ProyectoFinal2018/HW_Dron_V2/HW_Dron_V2.xls

Comment | Description | Proveedor | Cod. Proveedor | Encapsulado | Link | Quantity
IDC10 Macho Recto P=2.54mm | Header, 5x2-pin pinout horizontal | SDV Electronica |  | Through Hole | http://www.sdvelectronica.com.ar/conector-macho-recto-cable-plano-idc-10-pines-10-uni-139259442xJM | 10
IDC16 Macho Recto P=2.54mm | Modulo camara OV7670 | SDV Electronica |  |  | http://www.sdvelectronica.com.ar/conector-macho-recto-cable-plano-idc-16-pines-10-uni-146797591xJM | 10
2,2uF 16V X7R | Capacitor de placas paralelas | Mouser | 80-C0805C225K4R3123 | C0805 | https://ar.mouser.com/ | 50
ATWINC15x0-MR210 | IEEE 802.11 b/g/n SmartConnect IoT Module | Mouser | 556-1500MR210PB1952 | ATWINC15x0-MR210PB | https://ar.mouser.com/ | 5
BQ7692006PWR | 3-Series to 5-Series Cell Battery Monitor | Mouser | 595-BQ7692006PWR | TSSOP-20 | https://ar.mouser.com/ | 10
MPU9250 | IMU 9DOF | Mouser | 410-MPU-9250 | QFN24 | https://ar.mouser.com/ | 10
PSJ2NTEBL500F | Resistencia shunt 0.5mohm 10W | Mouser | 660-PSJ2NTEBL500F | SMD | https://ar.mouser.com | 10
STM32F407VGT6-100 | Microcontrolador STM32F407VGT6 100 pines | Mouser | 511-STM32F407VGT6 | QFP100 | https://ar.mouser.com/ | 10
XBEE PRO S2C MODULE | Conector modulo Zigbee Series 2 C | Mouser | 888-XBP24CAUIT-001 | Through Hole | https://ar.mouser.com/ | 2
XBeePRO_S2C-SMT | Conector modulo Zigbee Series 2 C encapsulado SMT | Mouser | 888-XB24CDMPIS-001 | SMT | https://ar.mouser.com/ | 5
100nF 50V X7R | Capacitor de placas paralelas | Microelectronica | C0805-0.1 | C0805 | http://www.microelectronicash.com/ | 200
10nF 25V X7R | Capacitor de placas paralelas | Microelectronica | C0805-0.01 | C0805 | http://www.microelectronicash.com/ | 100
1uF 16V X7R | Capacitor de placas paralelas | Microelectronica | C0805-1UF | C0805 | http://www.microelectronicash.com/ | 100
HEMB.P/CAB.PLANO 2X20 P=2.54mm | Conector para odroid c1+ | Elemon | CO4751060 | Through Hole | http://www.elemon.net | 10
0E 5% 1/8W | Resistencia | Elemon | RS3895900 | R0805 | http://www.elemon.net/ | 100
100E 5% 1/8W | Resistencia | Elemon | RS3896125 | R0805 | http://www.elemon.net/ | 100
100k 5% 1/8W | Resistencia | Elemon | RS3896305 | R0805 | http://www.elemon.net/ | 100
10k 5% 1/8W | Resistencia | Elemon | RS3896245 | R0805 | http://www.elemon.net/ | 100
10pF 50V | Capacitor de placas paralelas | Elemon | CA3278360 | C0805 | http://www.elemon.net/ | 100
10uF 25V 10% Tantalio | Capacitor polarizado | Elemon | CA3389022K | AVX C Case | http://www.elemon.net/ | 30
1k 5% 1/8W | Resistencia | Elemon | RS3896185 | R0805 | http://www.elemon.net/ | 100
1M 5% 1/8W | Resistencia | Elemon | RS3896365 | R0805 | http://www.elemon.net/ | 100
1N4007 | Diodo | Elemon | DI1202221 | SMA | http://www.elemon.net/ | 100
220uF 35V Electrolitico | Capacitor polarizado | Elemon | CA3629381 | CS8x10,5 SMD | http://www.elemon.net/ | 20
22E 5% 1/8W | Resistencia | Elemon | RS3896085 | R0805 | http://www.elemon.net/ | 100
270E 5% 1/8W | Resistencia | Elemon | RS3896150 | R0805 | http://www.elemon.net/ | 100
2k2 5% 1/8W | Resistencia | Elemon | RS3896205 | R0805 | http://www.elemon.net/ | 100
2k7 5% 1/8W | Resistencia | Elemon | RS3896210 | R0805 | http://www.elemon.net/ | 100
32.768KHZ C26T CQ | Resonador cerámico | Elemon | OS9009152 | Through Hole | http://www.elemon.net | 10
390E 5% 1/8W | Resistencia | Elemon | RS3896160 | R0805 | http://www.elemon.net/ | 100
3k9 5% 1/8W | Resistencia | Elemon | RS3896220 | R0805 | http://www.elemon.net/ | 100
470E 5% 1/8W | Resistencia | Elemon | RS3896165 | R0805 | http://www.elemon.net/ | 100
470uF 16V Electrolitico | Capacitor polarizado | Elemon | CA3629085 | 10x10 SMD | http://www.elemon.net/ | 20
47E 5% 1/8W | Resistencia | Elemon | RS3896105 | R0805 | http://www.elemon.net/ | 100
8MHz HC-49U/S CQ | Resonador cerámico | Elemon | OS9009452 | Through Hole | http://www.elemon.net | 10
DC Power Jack 2.5 RA | DC Power Jack 2.5 Right Angle Type Thin Plated Black Insulator ROHS | Elemon | MC6691355 | JACK_2.5DC_RA | http://www.elemon.net/ | 10
LM1117DTX-3.3/NOPB | Low dropout oscilator | Elemon | CI2707214D | TO-252-3 | http://www.elemon.net/ | 10
LM2596S-ADJ/NOPB | Switching Step-Down Voltage Regulator | Elemon | CI2709940 | TSS5B | http://www.elemon.net/ | 20
MA-02 VERT.P=2.54MM WF2S | Header, 2-pin | Elemon | CO5073010 | Through Hole | http://www.elemon.net | 40
MA-04 HORIZ.P=2.54MM WF4R | Conector para modulo ultrasonido de 40kHz | Elemon | CO5073040 | Through Hole | http://www.elemon.net | 50
STPS5L60S | Diodo Schottky | Elemon | DI1351350 | SMC | http://www.elemon.net/ | 60
TAC-SWITCH 4 CONT.6X6MM (7MM) 180GF | Pulsador de 4 pines | Elemon | MC5702109 | Through Hole | http://www.elemon.net | 10
ASP-129637-13 | PCIe/104 Connector A, OneBank Bottom | Digikey | SAM10885-ND | Surface Mount | https://www.digikey.com/ | 2
ASP-129646-22 | PCIe/104 Connector A, OneBank Bottom | Digikey | SAM10886-ND | Surface Mount | https://www.digikey.com/ | 2
BMP280 | Sensor de presion digital | Digikey | 828-1064-1-ND | 8-SMD | https://www.digikey.com/ | 10
CAP 220MF -20% +80% 3.3V SMD | Capacitor polarizado | Digikey | 604-1020-1-ND | SMD | https://www.digikey.com | 10
CONN HEADER PH TOP 3POS 2MM | Header, 3-pin | Digikey | 455-1705-ND | Through Hole | https://www.digikey.com | 40
CONN HEADER XH SIDE 2POS 2.5MM | Header, 2-pin | Digikey | 455-2257-ND | Through Hole | https://www.digikey.com | 40
CONN HEADER XH SIDE 4POS 2.5MM | Header, 4-pin | Digikey | 455-2243-ND | Through Hole | https://www.digikey.com/ | 40
DR127-330-R | Inductor | Digikey | M8852-ND | Through Hole | https://www.digikey.com/ | 20
CONN HOUSING PH 3POS 2.0MM | Conector hembra JST-PH 3 | Digikey | 455-1126-ND |  | https://www.digikey.com/ | 40
CONN TERMINAL 28-24AWG TIN | Conector terminal para JST | Digikey | 455-2148-1-ND |  | https://www.digikey.com/ | 40
4.7uF 16V | Capacitor de placas paralelas | Elemon | CA3279960 | C0805 | http://www.elemon.net/ | 50
2x5 Pin IDC Ribbon Cable | Cable con conectores hembra IDC10 | Sparkfun |  |  | https://www.sparkfun.com/products/8535 | 10
POSTE 90gra 40C SIMPLE FILA BAJO P=2.54MM | Poste simple fila 90 grados de 40 pines P=2.54mm | Elemon | CO4901060 |  | http://www.elemon.net/ | 10
POSTE RECTO 40C SF P=2.54MM | Poste simple fila recto de 40 pines P=2.54mm | Elemon | CO4901010 |  | http://www.elemon.net/ | 10
POSTE RECTO 80C DF P=2.54MM | Poste doble fila recto de 80 pines P=2.54mm | Elemon | CO4901030 |  | http://www.elemon.net/ | 10
CONN HOUSING 2.5MM 4POS | Housing JST-XH 4posiciones | Digikey | 455-2267-ND |  | https://www.digikey.com/ | 40
CABLE PLANO 50CONDUCT | Cable plano con 50 conductores P=0.05'' | Elemon | MC5351075 |  | http://www.elemon.net/ | 40
PIN HEMBRA PARA HOUSING TIPO HUX HU | Terminal para conector hembra para housing para HUX HU | Elemon | CO5073600 |  | http://www.elemon.net/ | 40
HE-04 P/CABLE P=2.54MM HU4 | Conector hembra housing HU4 | Elemon | CO5073230 |  | http://www.elemon.net/ | 40
OV7670 | Camara | Ebay |  |  | https://www.ebay.com/itm/VGA-OV7670-CMOS-Camera-Module-Lens-CMOS-640X480-SCCB-Compatible-W-I2C-Interface-/400373092344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 | 2
STLINK V2 MINI CON IDC10 | Debugger STLINK V2 MINI con conector IDC10 (2x5) | Monarca Electronica |  |  | https://www.monarcaelectronica.com.ar/programadores/programador-dbuger-usb-st-link-v2-stm32-stm8-con-cable-mona/ | 10
SEPARADOR 20MM PASANTE 1/8" | Separador de 1/8'' 20mm | Elemon | MC6451075 |  | http://www.elemon.net/ | 100
Bateria Li-Po 11.1V 3S 2200mAh | Bateria Li-Po de 11.1V y 2200mAh | Hobbyfiesta |  |  | https://articulo.mercadolibre.com.ar/MLA-704200986-bateria-lipo-3s-111v-2200mah-drones-avion-rc-turnigy-litio-_JM | 5
Ficha Xt-60 macho | Fichas xt-60 macho | RC FLASH |  |  | https://articulo.mercadolibre.com.ar/MLA-692913500-5-pares-fichas-xt-60-drones-autos-aviones-a-rc-litio-lipo-_JM | 10
Ficha Xt-60 hembra | Fichas xt-60 hembra | RC FLASH |  |  | https://articulo.mercadolibre.com.ar/MLA-692913500-5-pares-fichas-xt-60-drones-autos-aviones-a-rc-litio-lipo-_JM | 10
Conector Dean T macho | Fichas Dean T macho | Hobbyfiesta |  |  | https://articulo.mercadolibre.com.ar/MLA-674440105-ficha-conector-dean-t-el-par-macho-hembra-radio-control-_JM | 10
Conector Dean T hembra | Fichas Dean T hembra | Hobbyfiesta |  |  | https://articulo.mercadolibre.com.ar/MLA-674440105-ficha-conector-dean-t-el-par-macho-hembra-radio-control-_JM | 10
ESC+Brushless+Helices x4 | Combo Motor Brushless + Speed Esc 30a + Helices Drone Avion x4 todo | Hobbyfiesta |  |  | https://articulo.mercadolibre.com.ar/MLA-690426244-oferta-combo-4-motores-brushless-4-speed-esc-30-amp-8-helice-_JM | 5
MEMORIA KINGSTON 32GB MICRO SD HC CLASS 10 | Memoria Micro SD 32GB clase 10 KINGSTON | PASCAL ONLINE |  |  | https://pascalonline.com.ar/producto/memoria-32gb-micro-sd-hc-class-10/ | 15
Frame F450 |  | ebay |  |  | https://www.ebay.com/itm/F450-Multicopter-Frame-Arm-For-DJI-Center-Plate-TOP-And-Bottom-Landing-Wheel/263110310141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 | 5
ODROID C1+ |  | Hardkernel |  |  | http://www.hardkernel.com/main/products/prdt_info.php?g_code=G143703355573 | 3
Rc Futaba + Receptor | Radiocontrol Futaba + receptor |  |  |  | https://articulo.mercadolibre.com.ar/MLA-607281142-rc-futaba-6-canales-receptor-uav-drones-fpv-_JM | 1
SiK telemetry radio | HKPilot Transceiver Telemetry Radio Set V2 | Hobbyking |  |  | https://hobbyking.com/en_us/hkpilot-transceiver-telemetry-radio-set-v2-433mhz.html | 5
Autopilot DJI Naza M-Lite | Kit del DJI Naza |  |  |  | https://articulo.mercadolibre.com.ar/MLA-722191450-autopilot-dji-naza-m-lite-drone-v11-con-antena-gps-ubec-_JM | 5
Scanse Sweep | Lidar 360 grados | Sparkfun |  |  | https://www.sparkfun.com/products/retired/14117 | 1
