ProyectoFinal2018/HW_Dron_V2/HW_Dron_V2.PDF

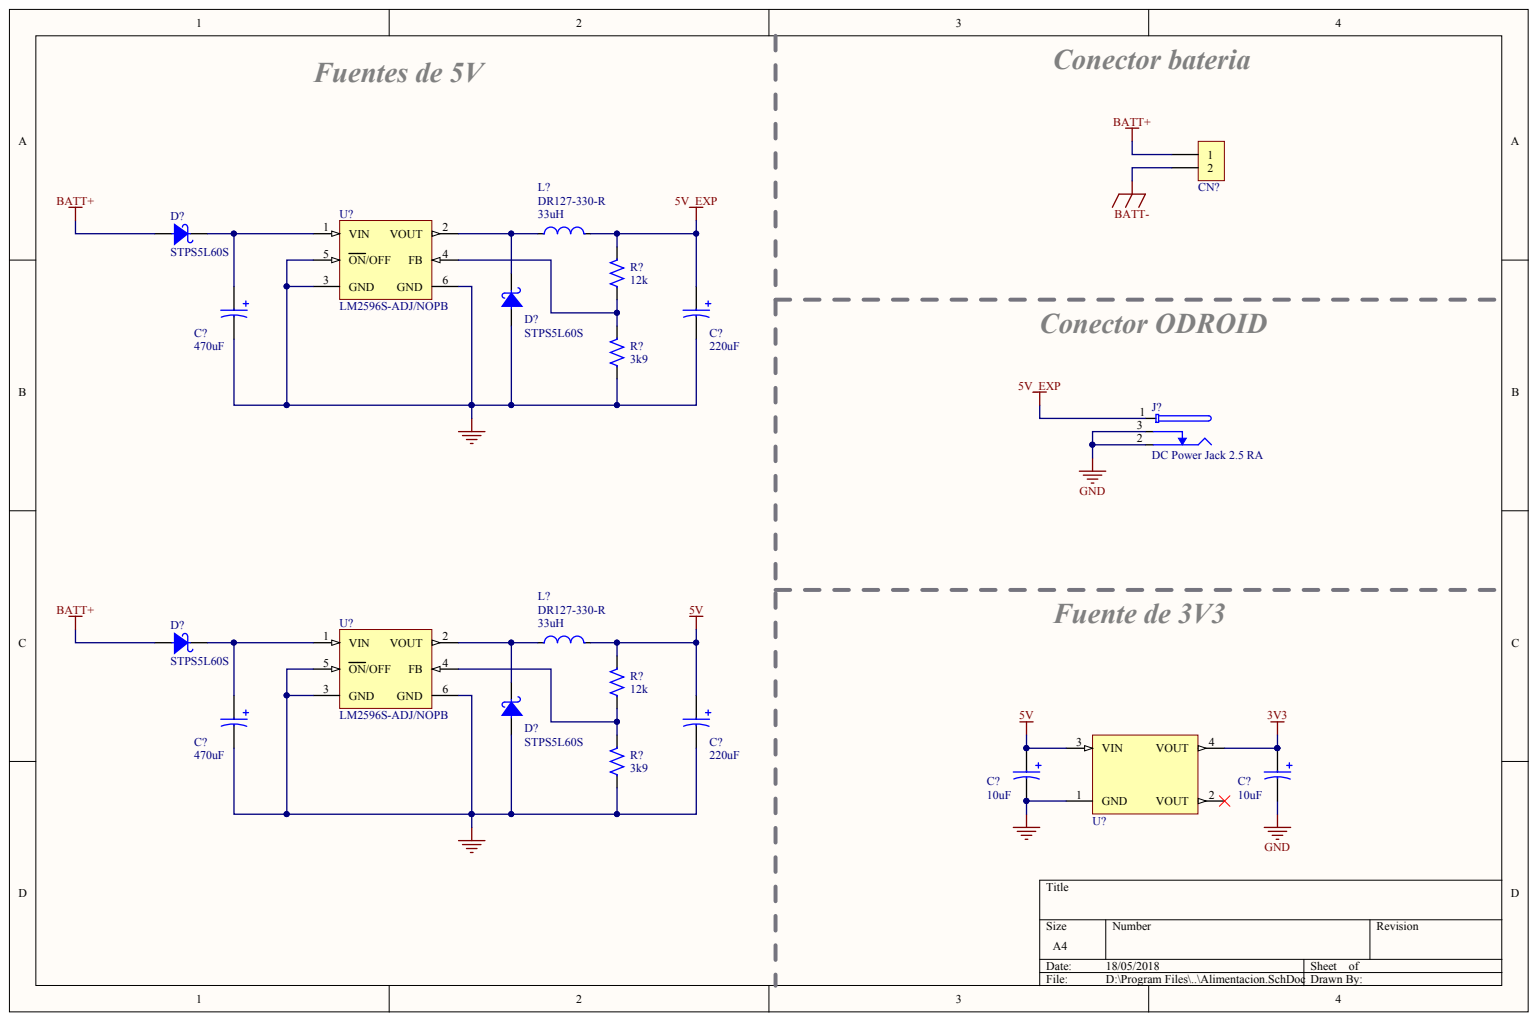
[picture p1: page 1]

DC Power Jack 2.5 RA

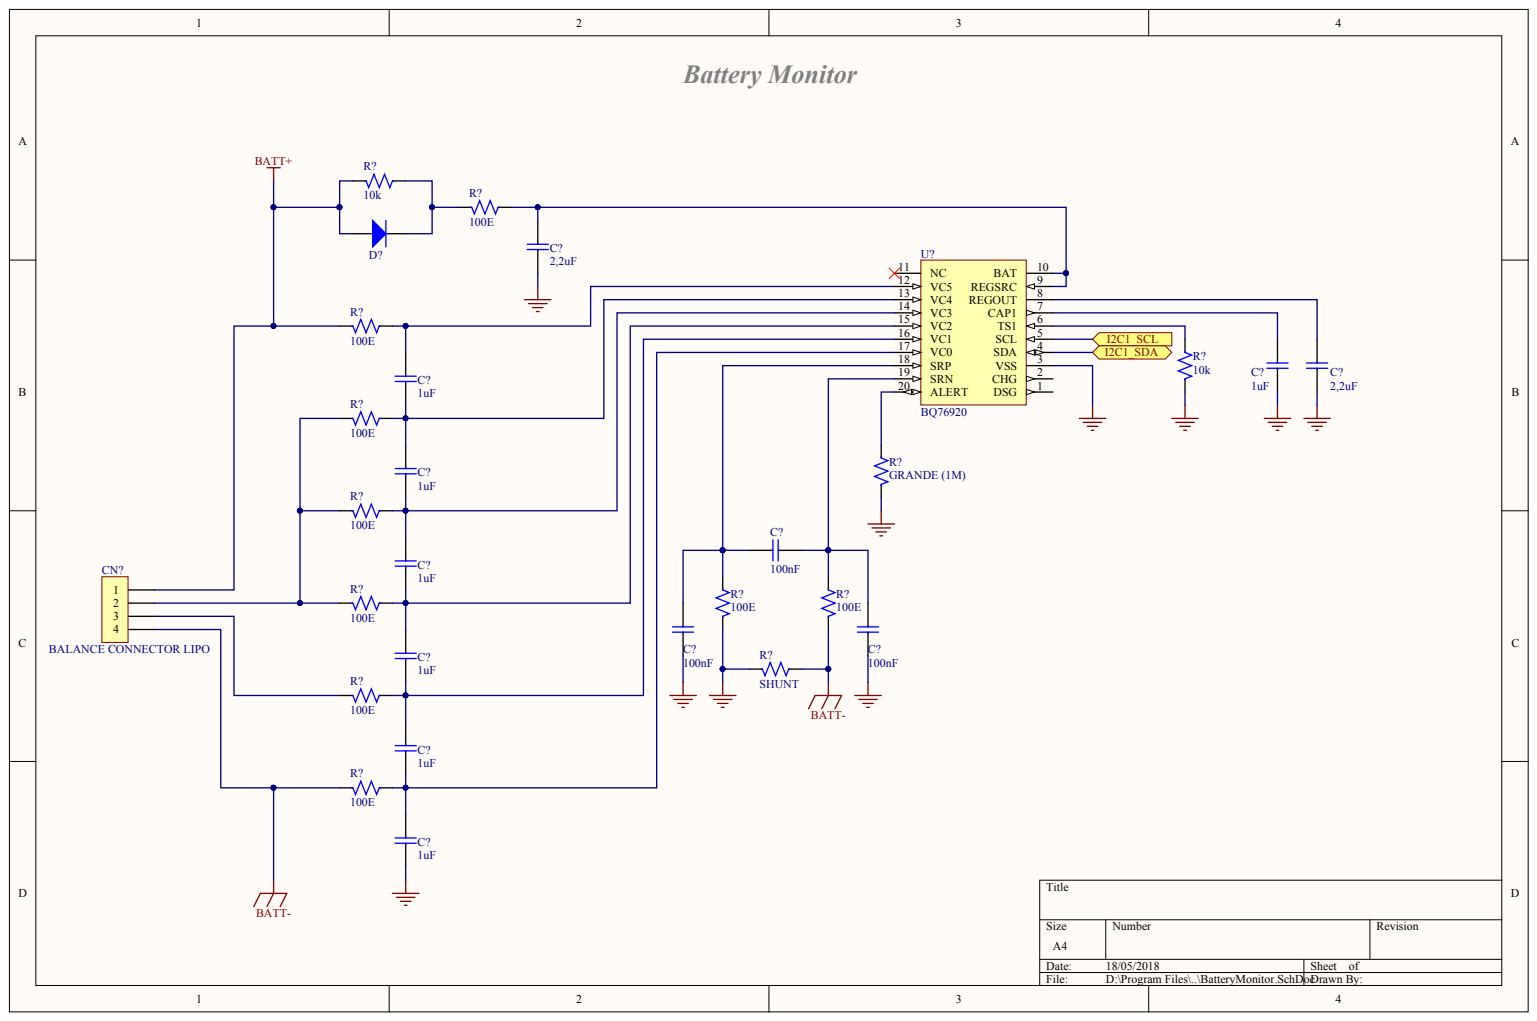
[picture p2: page 2]

VC5 12 DSG | 10 NC 11

VC3 14 | 1 CHG 2 VSS 3 SDA 4 SCL 5 TS1 6 CAP1 7 REGOUT 8 REGSRC 9 BAT

VC0 17
SRP 18
SRN 19
ALERT 20

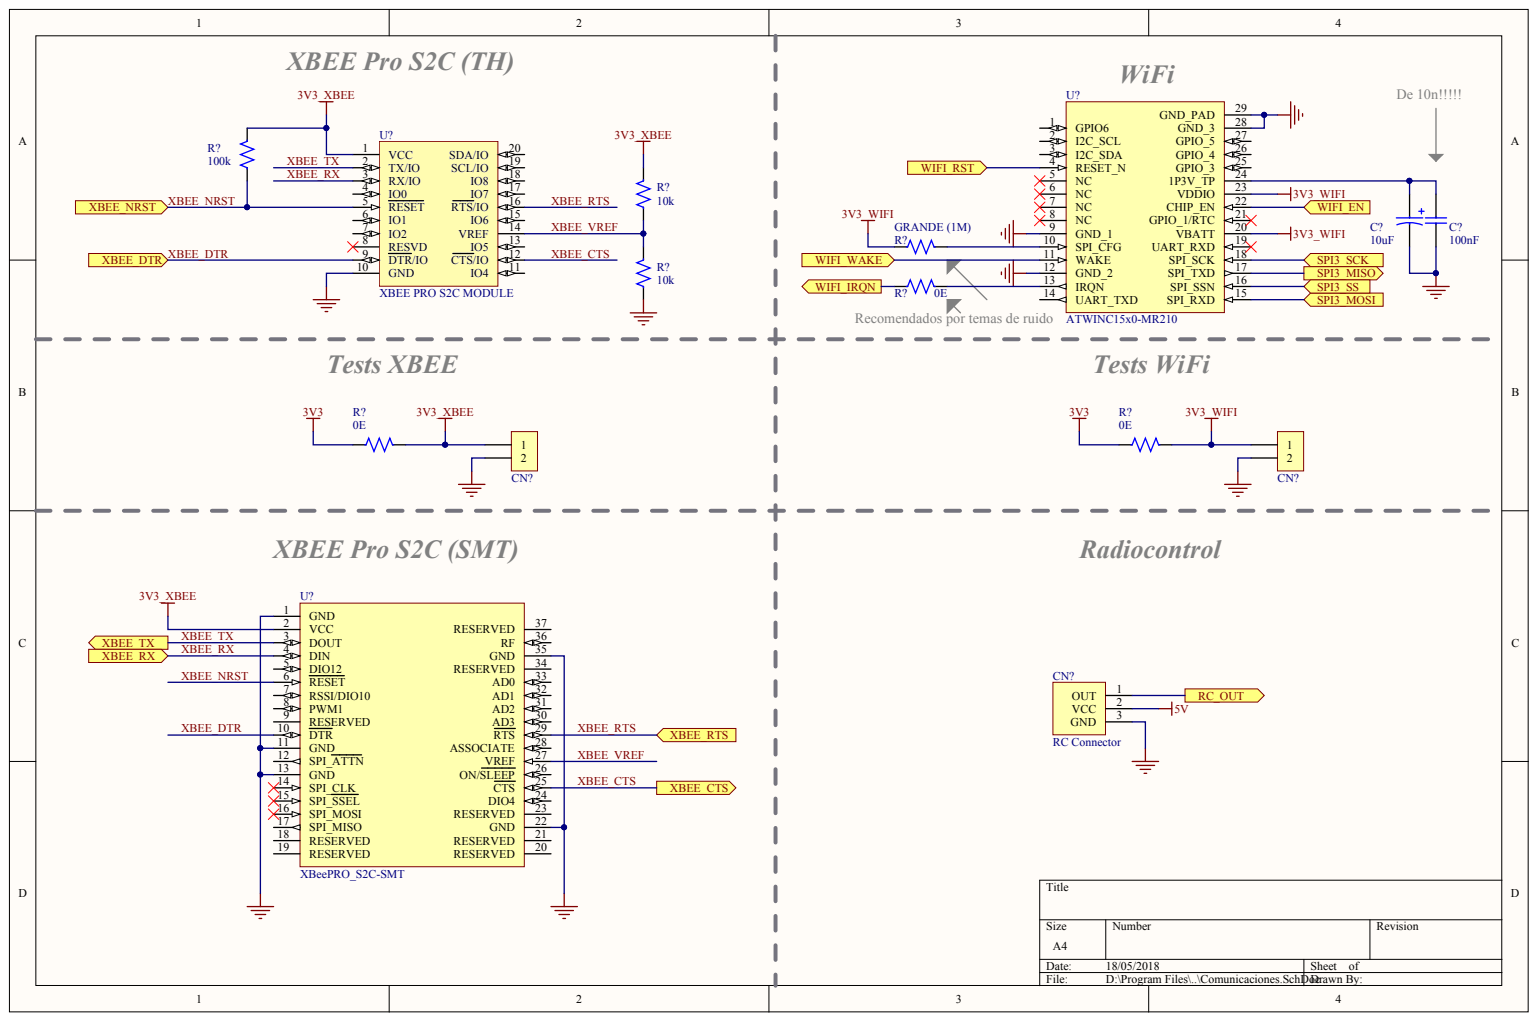
[picture p3: page 3]

Recomendados por temas de ruido

VCC 2
DOUT 3
DIN 4
DIO12 5

RSSI/DIO10 7

SPI_ATTN 12

SPI_CLK 14

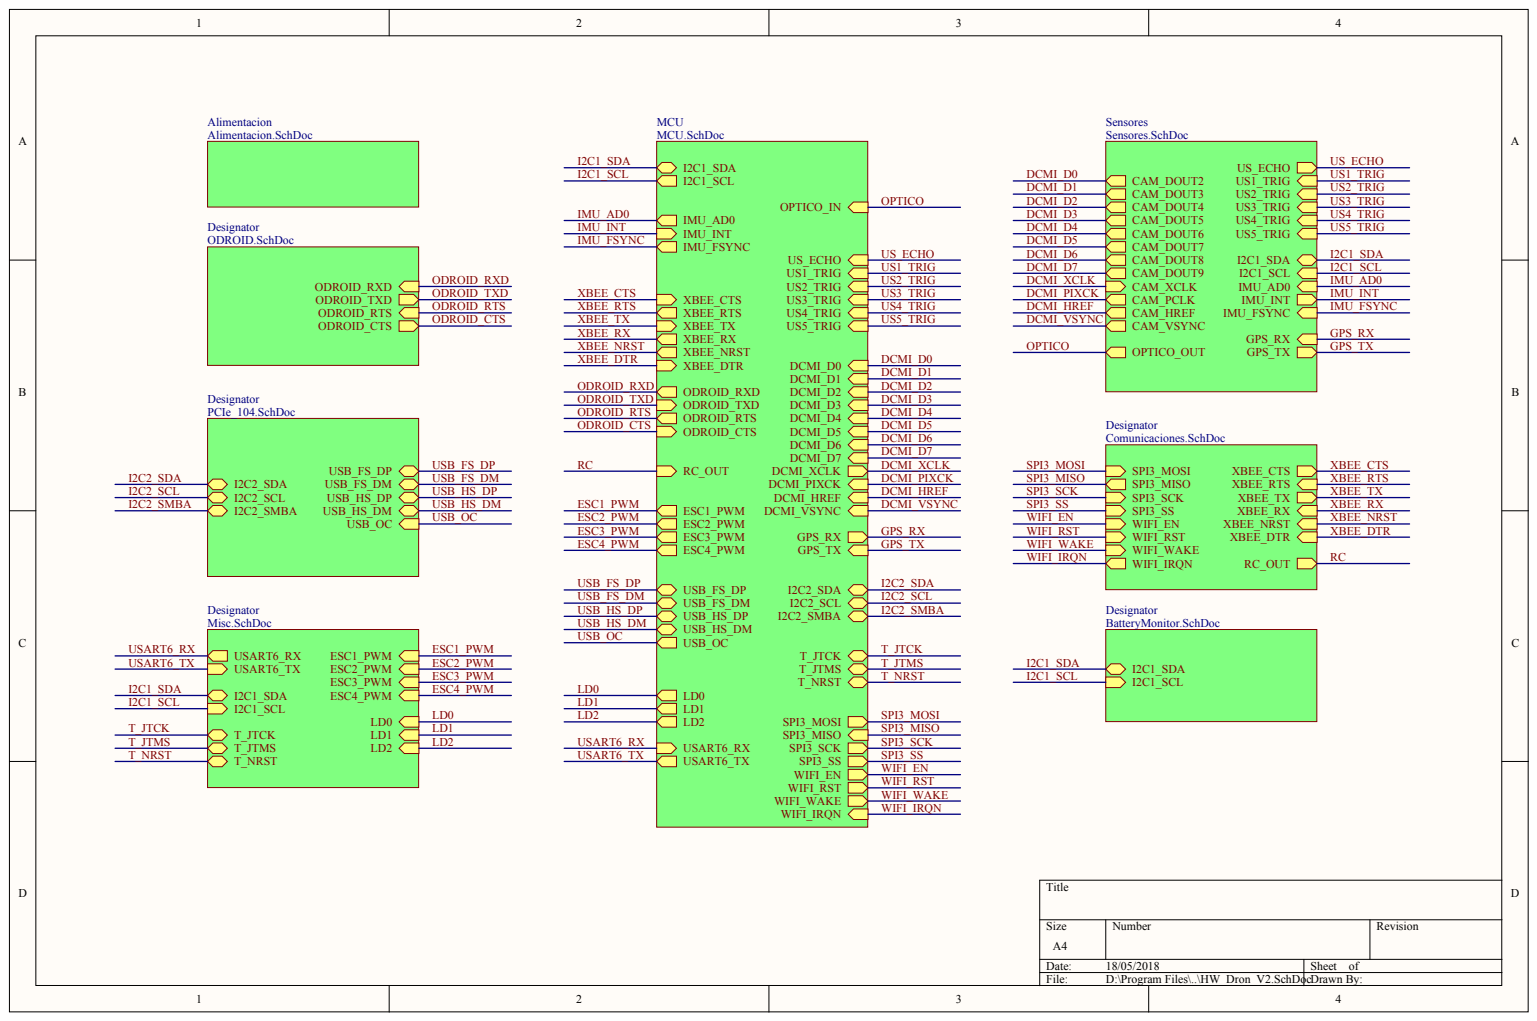
[picture p4: page 4]

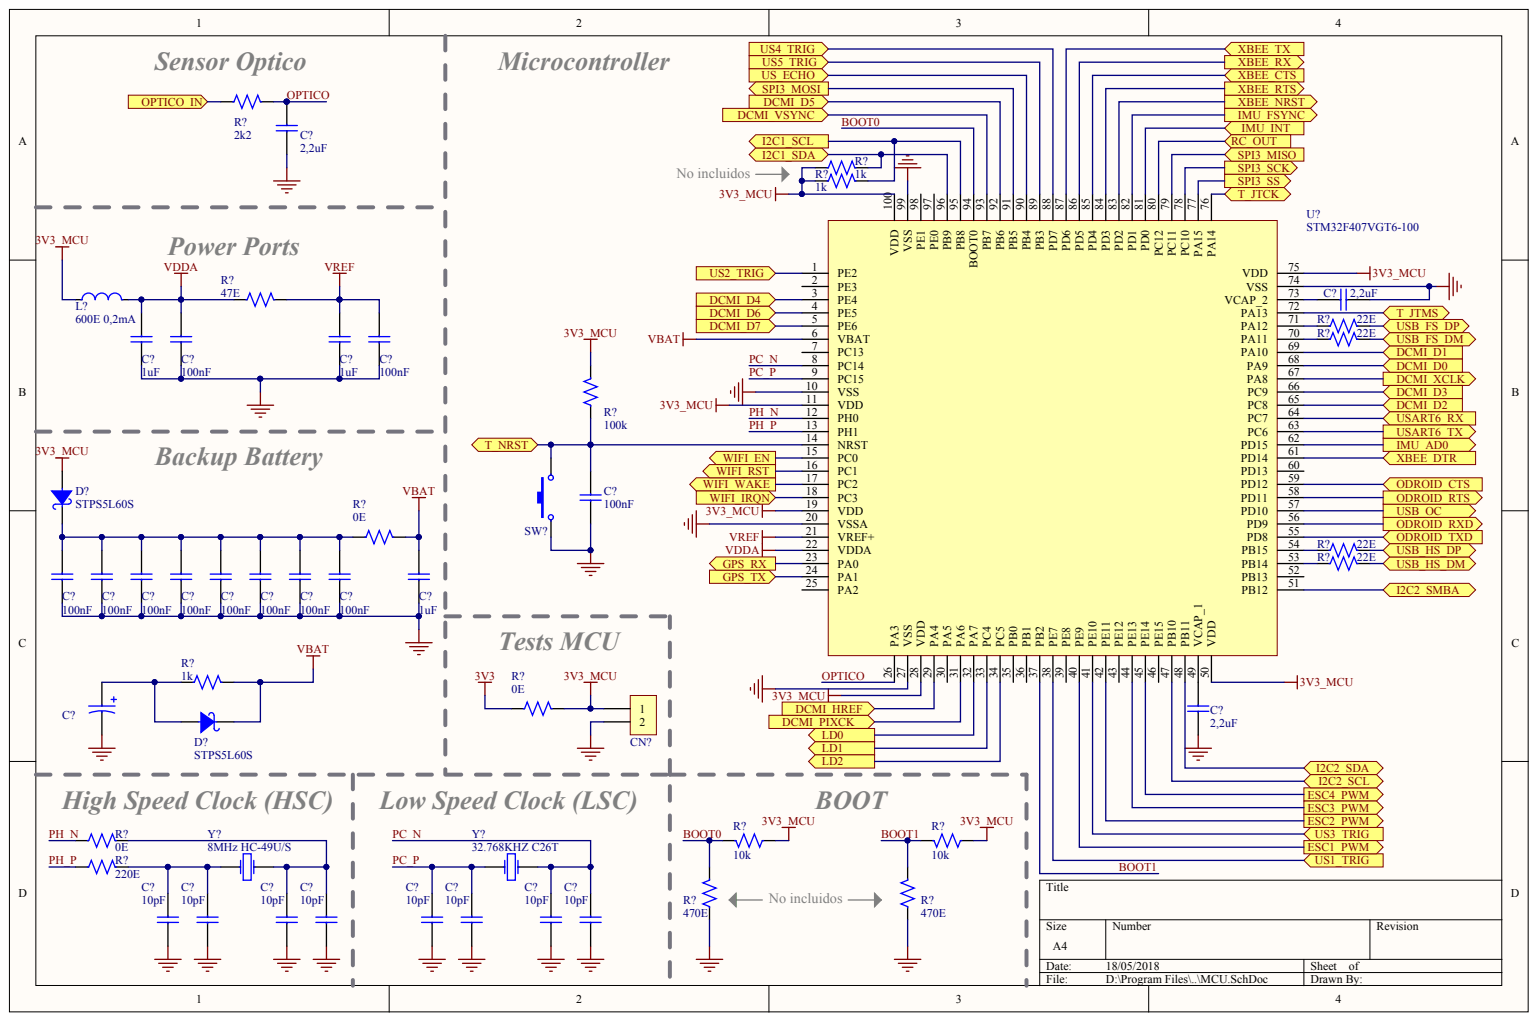
[picture p5: page 5]

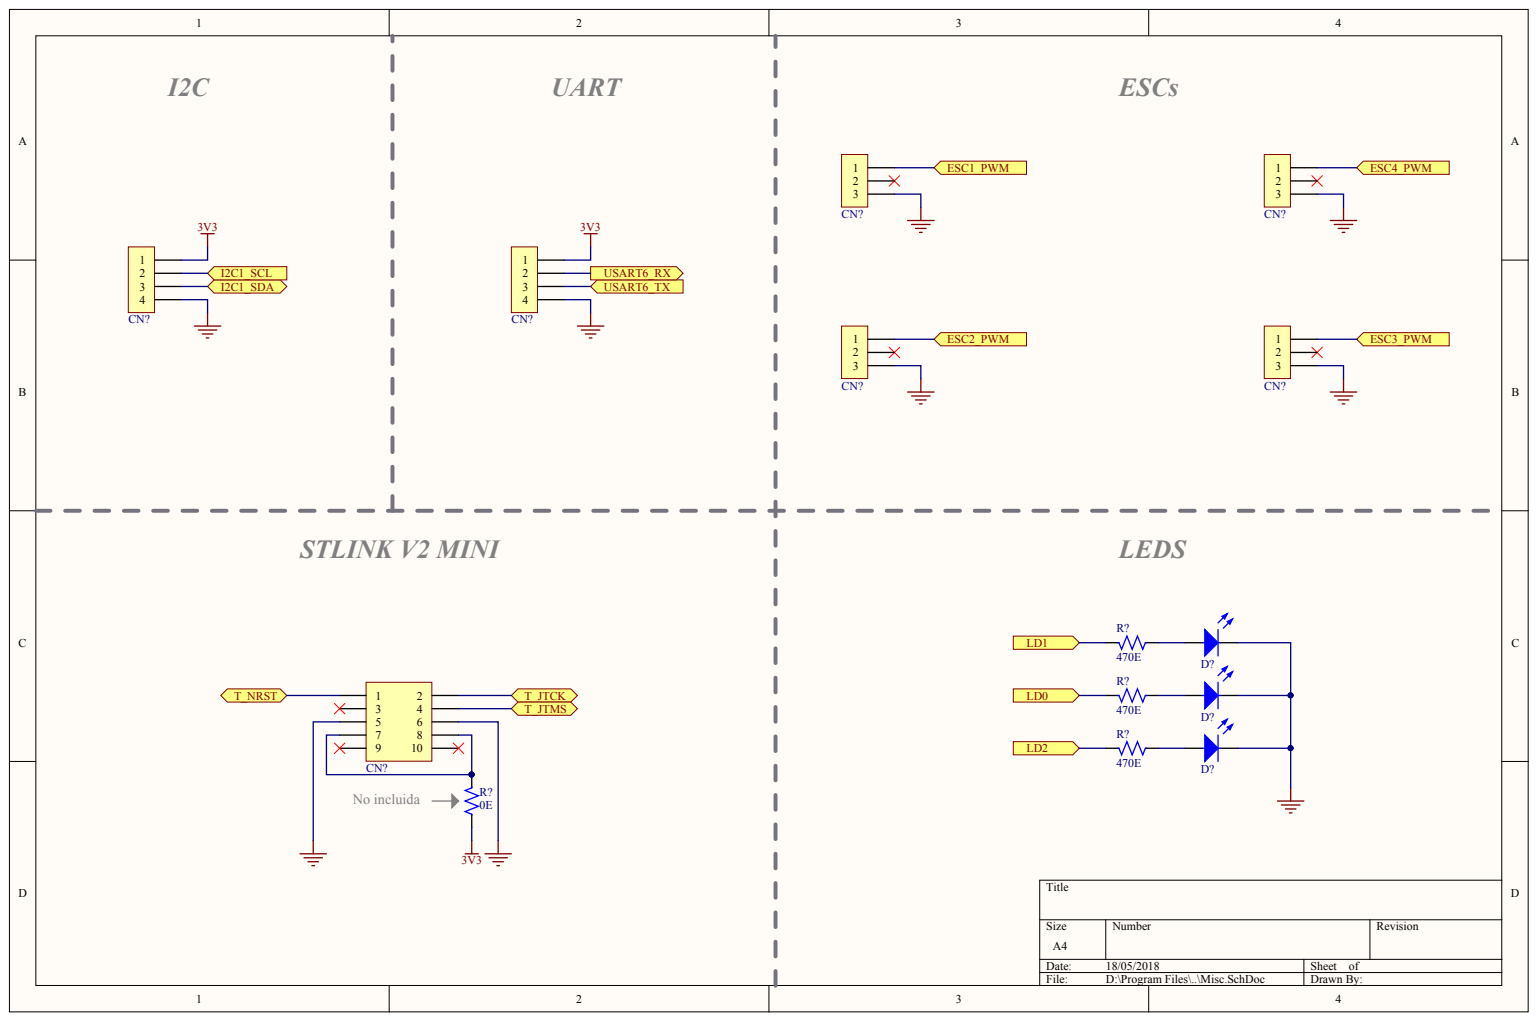
[picture p6: page 6]

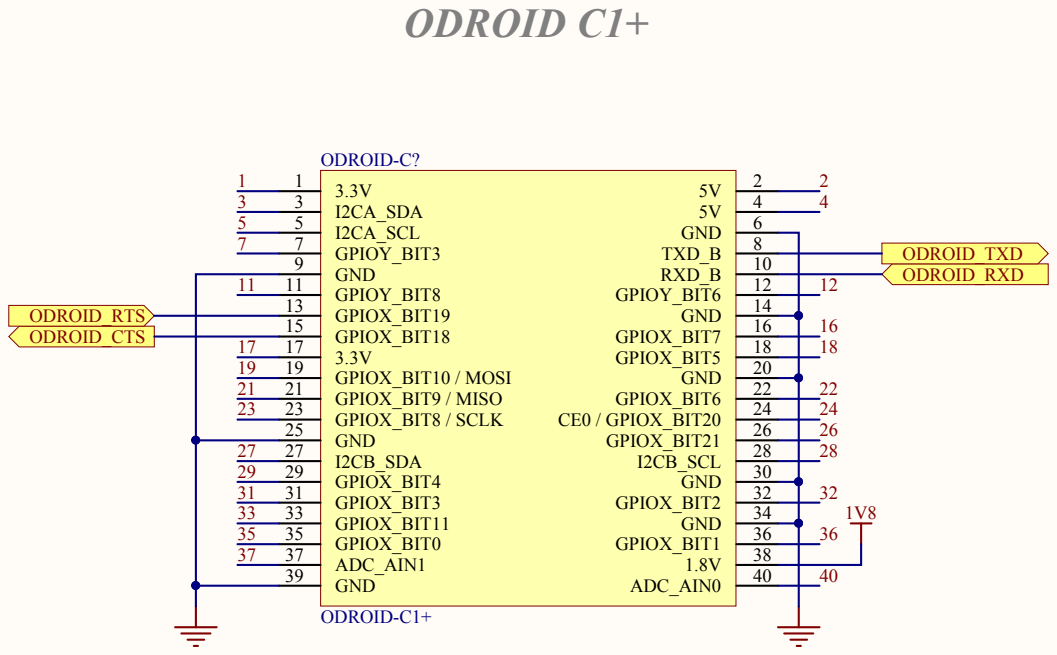
[picture p7: page 7]

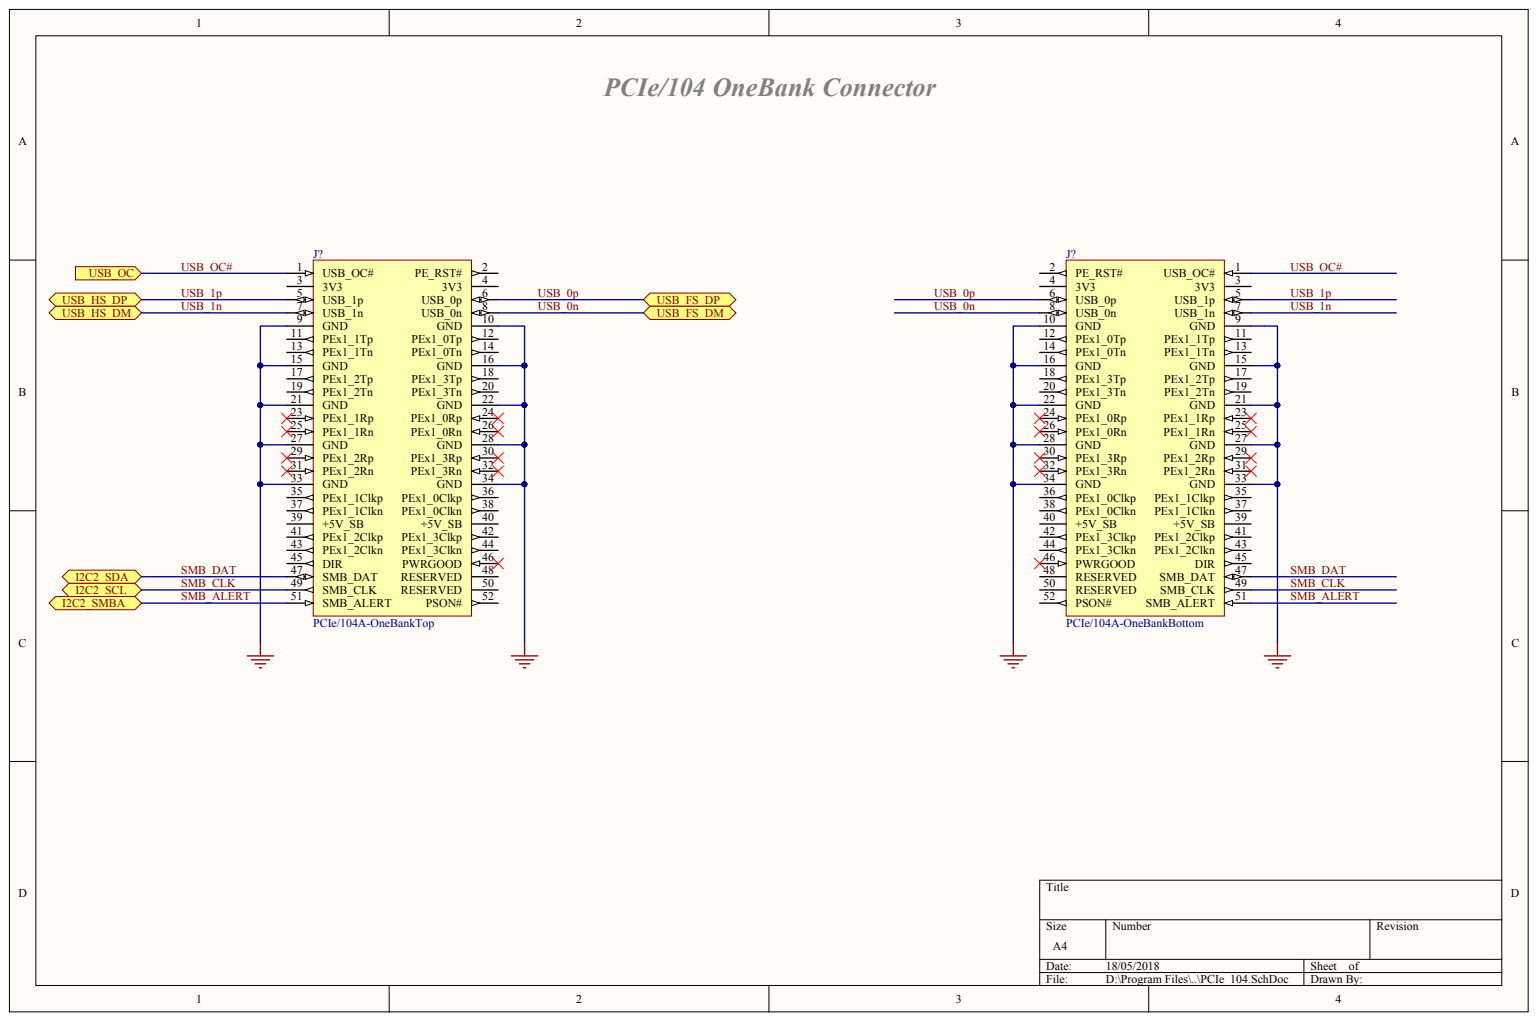
[picture p8: page 8]

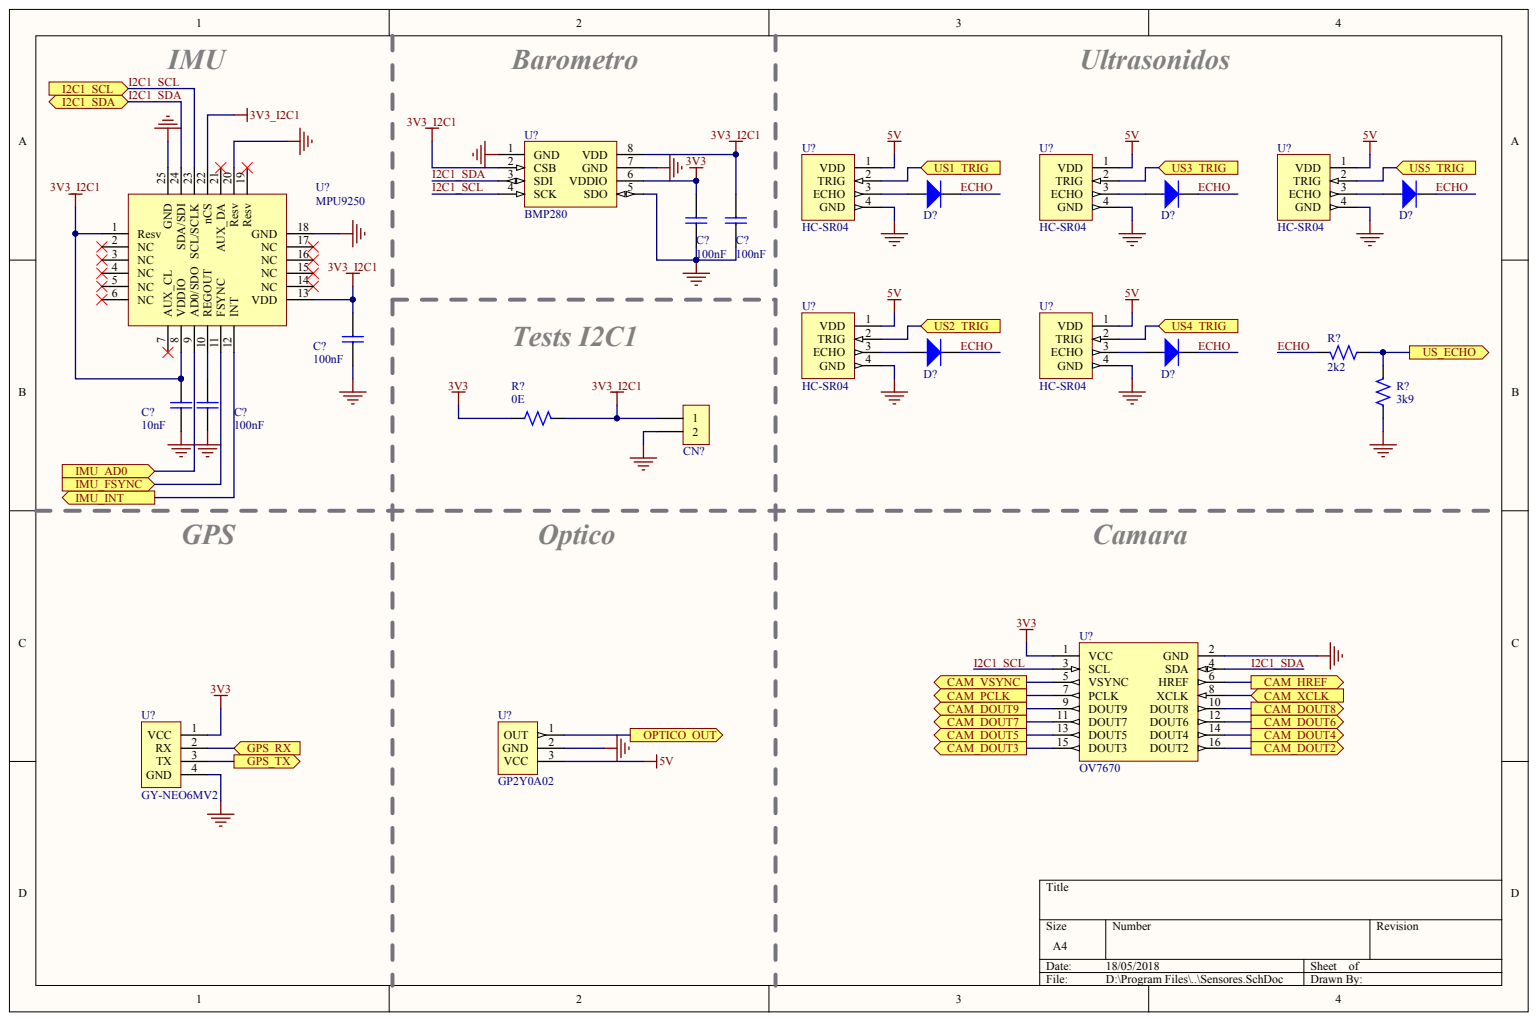
[picture p9: page 9]

SCL/SCLK 23 SDA/SDI 24 GND 25
