ProyectoFinal2018/HW_Dron_V2/(list of files, drawings)

Other design files:
Alimentacion.SchDoc
BatteryMonitor.SchDoc
Comunicaciones.SchDoc
HW_Dron_V2.PrjPcb
HW_Dron_V2.SchDoc
HW_Dron_V2.SchLib
MCU.SchDoc
Misc.SchDoc
ODROID.SchDoc
PCIe_104.SchDoc
Sensores.SchDoc
USB_OTG.SchDoc
