ProyectoFinal2018/HW_Dron_V2/HW_Dron_V2.ioc

Mcu.UserName=STM32F407VGTx
PA0-WKUP.Signal=UART4_TX
PA1.Signal=UART4_RX
PA10.Signal=DCMI_D1
PA11.Signal=USB_OTG_FS_DM
PA12.Signal=USB_OTG_FS_DP
PA13.Signal=SYS_JTMS-SWDIO
PA14.Signal=SYS_JTCK-SWCLK
PA15.Signal=SPI3_NSS
PA4.Signal=DCMI_HSYNC
PA6.Signal=DCMI_PIXCK
PA7.GPIO_Label=LD0
PA7.Signal=GPIO_Output
PA8.GPIO_Label=DCMI_XCLK
PA8.Signal=RCC_MCO_1
PA9.Signal=DCMI_D0
PB10.Signal=I2C2_SCL
PB11.Signal=I2C2_SDA
PB12.Signal=I2C2_SMBA
PB14.Signal=USB_OTG_HS_DM
PB15.Signal=USB_OTG_HS_DP
PB2.GPIO_Label=BOOT1
PB2.Signal=GPIO_Analog
PB3.Signal=SYS_JTDO-SWO
PB4.GPIO_Label=US_ECHO
PB4.Signal=S_TIM3_CH1
PB5.Signal=SPI3_MOSI
PB6.Signal=DCMI_D5
PB7.Signal=DCMI_VSYNC
PB8.Signal=I2C1_SCL
PB9.Signal=I2C1_SDA
PC0.GPIO_Label=WIFI_EN
PC0.Signal=GPIO_Output
PC1.GPIO_Label=WIFI_RST
PC1.Signal=GPIO_Output
PC10.Signal=SPI3_SCK
PC11.Signal=SPI3_MISO
PC12.Signal=UART5_TX
PC14-OSC32_IN.Signal=RCC_OSC32_IN
PC15-OSC32_OUT.Signal=RCC_OSC32_OUT
PC2.GPIO_Label=WIFI_WAKE
PC2.Signal=GPIO_Output
PC3.GPIO_Label=WIFI_IRQN
PC3.Signal=GPIO_Input
PC4.GPIO_Label=LD1
PC4.Signal=GPIO_Output
PC5.GPIO_Label=LD2
PC5.Signal=GPIO_Output
PC6.Signal=USART6_TX
PC7.Signal=USART6_RX
PC8.Signal=DCMI_D2
PC9.Signal=DCMI_D3
PD0.GPIO_Label=IMU_INT
PD0.Signal=GPXTI0
PD1.GPIO_Label=IMU_FSYNC
PD1.Signal=GPIO_Output
PD10.GPIO_Label=USB_HS_OC
PD10.Signal=GPIO_Input
PD11.Signal=USART3_CTS
PD12.Signal=USART3_RTS
PD14.GPIO_Label=XBEE_DTR
PD14.Signal=GPIO_Input
PD15.GPIO_Label=IMU_AD0
PD15.Signal=GPIO_Output
PD2.GPIO_Label=XBEE_NRST
PD2.Signal=GPIO_Output
PD3.Signal=USART2_CTS
PD4.Signal=USART2_RTS
PD5.Signal=USART2_TX
PD6.Signal=USART2_RX
PD7.GPIO_Label=US4_TRIG
PD7.Signal=GPIO_Output
PD8.Signal=USART3_TX
PD9.Signal=USART3_RX
PE10.GPIO_Label=US3_TRIG
PE10.Signal=GPIO_Output
PE11.Signal=S_TIM1_CH2
PE13.Signal=S_TIM1_CH3
PE14.Signal=S_TIM1_CH4
PE2.GPIO_Label=US2_TRIG
PE2.Signal=GPIO_Output
PE3.GPIO_Label=US5_TRIG
PE3.Signal=GPIO_Output
PE4.Signal=DCMI_D4
PE5.Signal=DCMI_D6
PE6.Signal=DCMI_D7
PE7.GPIO_Label=US1_TRIG
PE7.Signal=GPIO_Output
PE9.Signal=S_TIM1_CH1
PH0-OSC_IN.Signal=RCC_OSC_IN
PH1-OSC_OUT.Signal=RCC_OSC_OUT
