ProyectoFinal2018/HW_Dron_V2/(commit log)

2018-05-01 Agregado I2C1 para la IMU
2018-05-01 Revisadas librerias de footprints y esquematico de componentes utilizados hasta el momento
    [HW_Dron_V2.SchLib]
2018-05-01 Agregados capacitores y alimentacion segun la STM32F4Discovery, y se agrego el I2C1
    [MCU.SchDoc]
2018-05-01 Agregada la IMU
    [Sensores.SchDoc]
2018-05-01 Agregado el MCU y sensores
    [HW_Dron_V2.SchDoc]
2018-05-01 Comienzo del HW del Dron V2
    [HW_Dron_V2.PrjPcb]
2018-05-01 Agregados BMP280 y ultrasonidos. Resta definir de estos ultimos los pines de trigger de cada uno
    [HW_Dron_V2.SchDoc, HW_Dron_V2.SchLib, MCU.SchDoc, Sensores.SchDoc]
2018-05-17 Agregados modulos de comunicacion (falta wifi), battery monitor (falta ver termistor) y acondicionado con al v1 cambiando cosas de lugar. Resta ver pc104 entre otras cosas
    [Alimentacion.SchDoc, BatteryMonitor.SchDoc, Comunicaciones.SchDoc, HW_Dron_V2.PrjPcb, HW_Dron_V2.SchDoc, HW_Dron_V2.SchLib, MCU.SchDoc, ODROID.SchDoc]
2018-05-18 Faltaria agregar el XBee mini y el PC104 para terminar con la primer revision del sch
    [Alimentacion.SchDoc, BatteryMonitor.SchDoc, Comunicaciones.SchDoc, HW_Dron_V2.PrjPcb, HW_Dron_V2.SchDoc, HW_Dron_V2.SchLib, MCU.SchDoc, Misc.SchDoc]
2018-05-18 Finalizado con el esquematico, falta agregar proveedores y revisar un poco
    [BatteryMonitor.SchDoc, Comunicaciones.SchDoc, HW_Dron_V2.PrjPcb, HW_Dron_V2.SchDoc, HW_Dron_V2.SchLib, MCU.SchDoc, Misc.SchDoc, PCIe_104.SchDoc]
2018-06-01 Ubicados casi todos los componentes. Por ahora no se incluye el battery monitor
    [Alimentacion.SchDoc, BatteryMonitor.SchDoc, Comunicaciones.SchDoc, HW_Dron_V2.PrjPcb, HW_Dron_V2.SchDoc, HW_Dron_V2.SchLib, HW_Dron_V2.xls, MCU.SchDoc]
2018-06-02 Ubicados todos los componentes sobre el pcb
    [Alimentacion.SchDoc, MCU.SchDoc]
2018-07-01 Placa ruteada, falta revision
    [Alimentacion.SchDoc, Comunicaciones.SchDoc, HW_Dron_V2.PrjPcb, HW_Dron_V2.SchDoc, HW_Dron_V2.SchLib, MCU.SchDoc, Misc.SchDoc, PCIe_104.SchDoc]
2019-04-05 Cambios en capas de fuente, agrandado agujeros de conectores y cambio de pistas de MCU de alimentacion
    [Alimentacion.SchDoc, Comunicaciones.SchDoc, HW_Dron_V2.PrjPcb, HW_Dron_V2.SchDoc, MCU.SchDoc, ODROID.SchDoc, PCIe_104.SchDoc]
2019-04-06 Cambiados RX y TX y componentes por tema de corriente. Verificarr
    [Comunicaciones.SchDoc, HW_Dron_V2.SchDoc, MCU.SchDoc, Misc.SchDoc, ODROID.SchDoc, PCIe_104.SchDoc, Sensores.SchDoc]
2019-04-07 Placa lista para mandar a Mayer
    [Comunicaciones.SchDoc, HW_Dron_V2.SchDoc, MCU.SchDoc, Misc.SchDoc, Sensores.SchDoc]
2019-04-15 Placa V2.1 corregida y enviada
    [Alimentacion.SchDoc, HW_Dron_V2.PrjPcb, Misc.SchDoc]
